iluducvuong/Do-an-khoa-so-dien-tu-Dighital-Key-/PCB/PCB.pdf

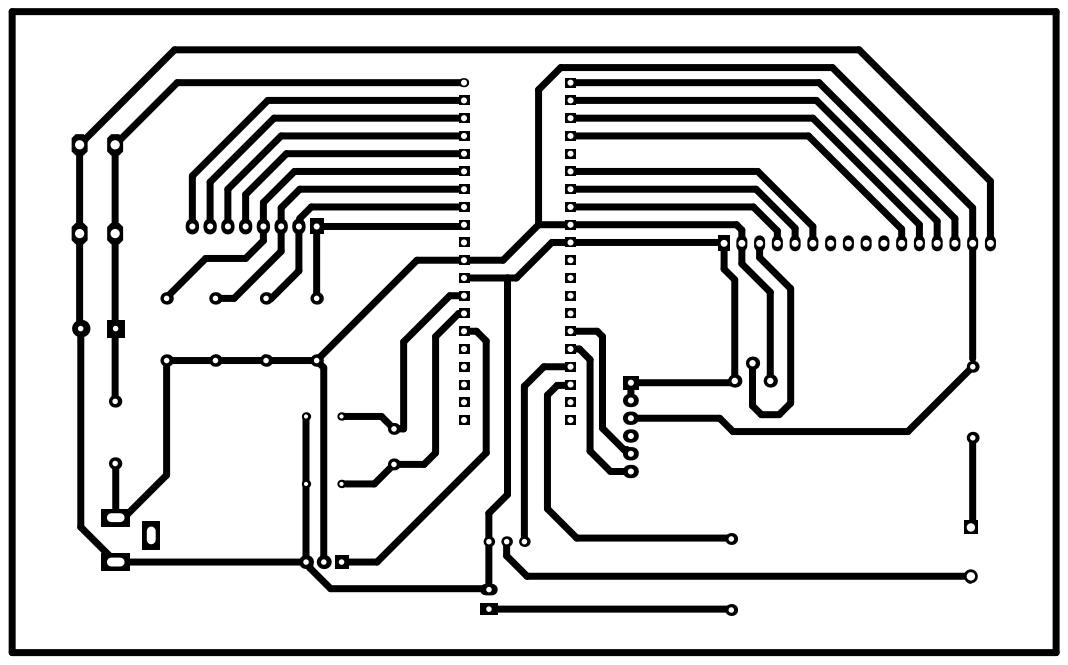
[picture p15: page 1]
