iluducvuong/Do-an-khoa-so-dien-tu-Dighital-Key-/PCB/PCB1.pdf

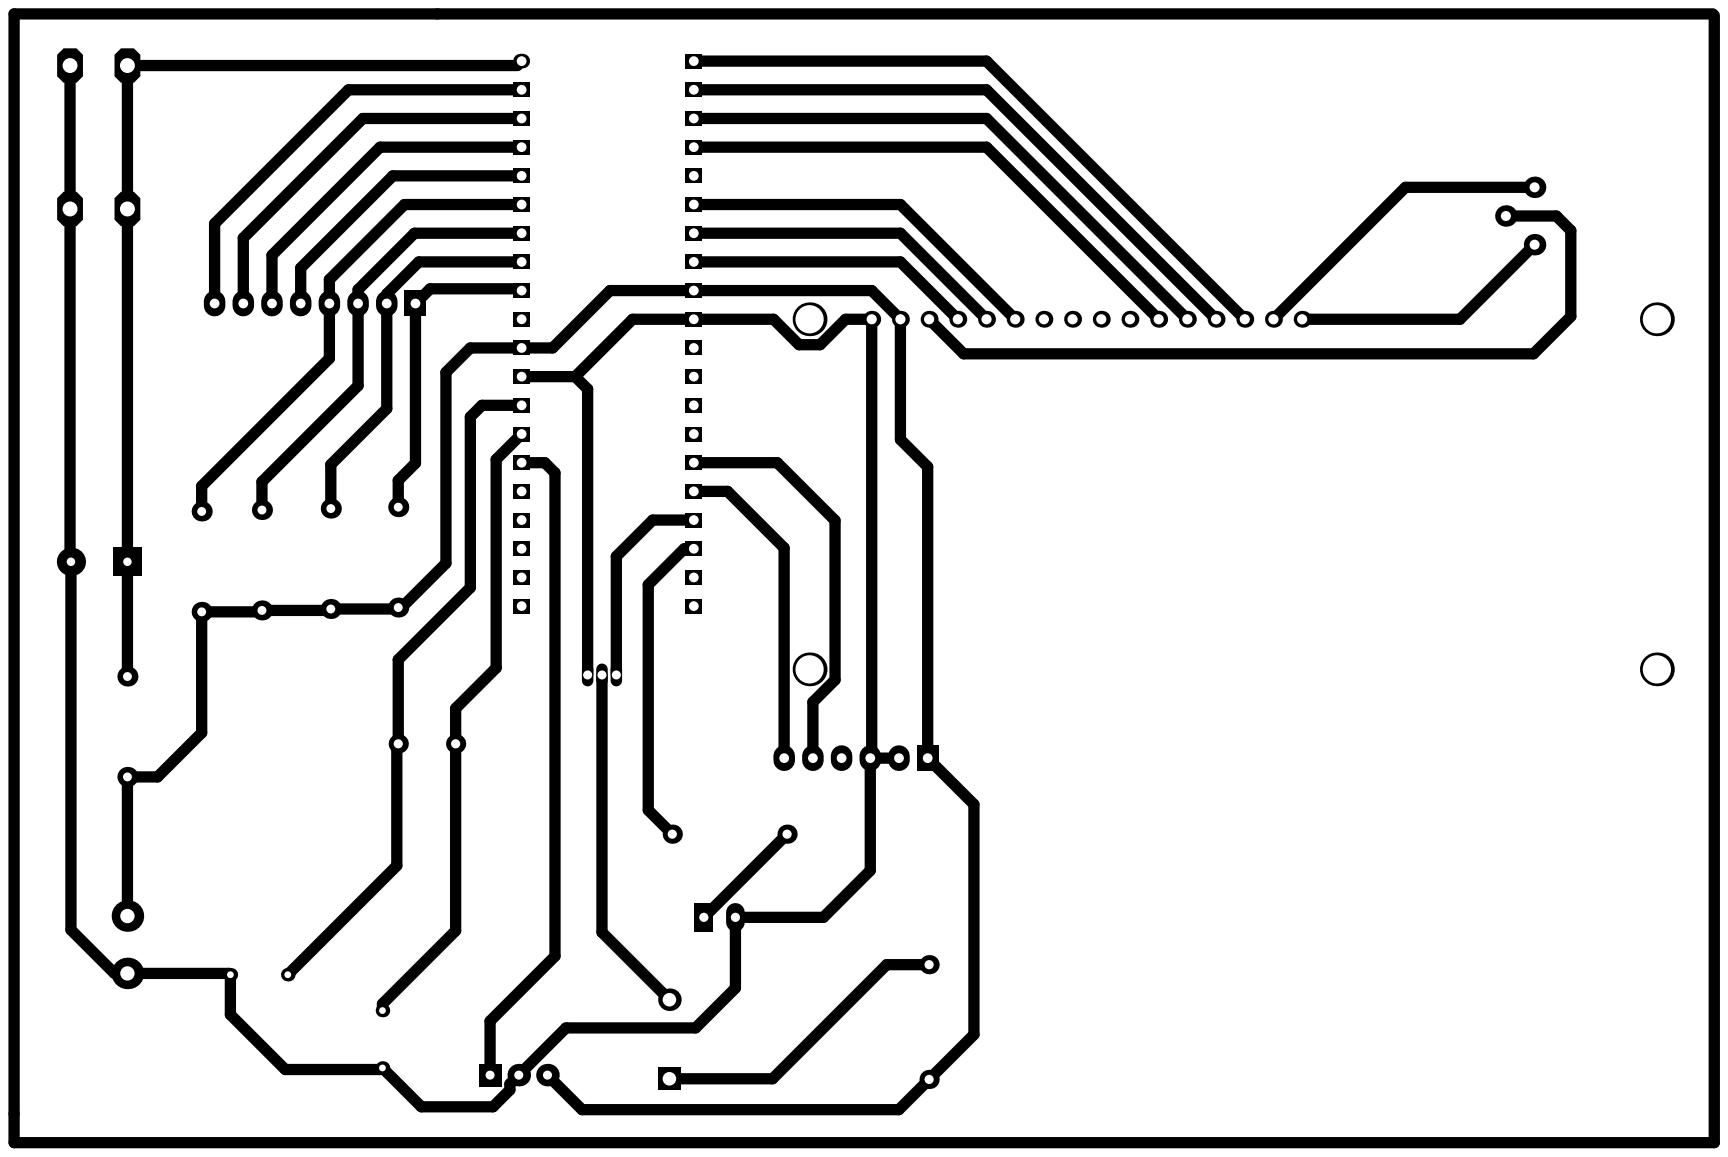
[picture p16: page 1]
