iluducvuong/Do-an-khoa-so-dien-tu-Dighital-Key-/PCB/PCB2.pdf

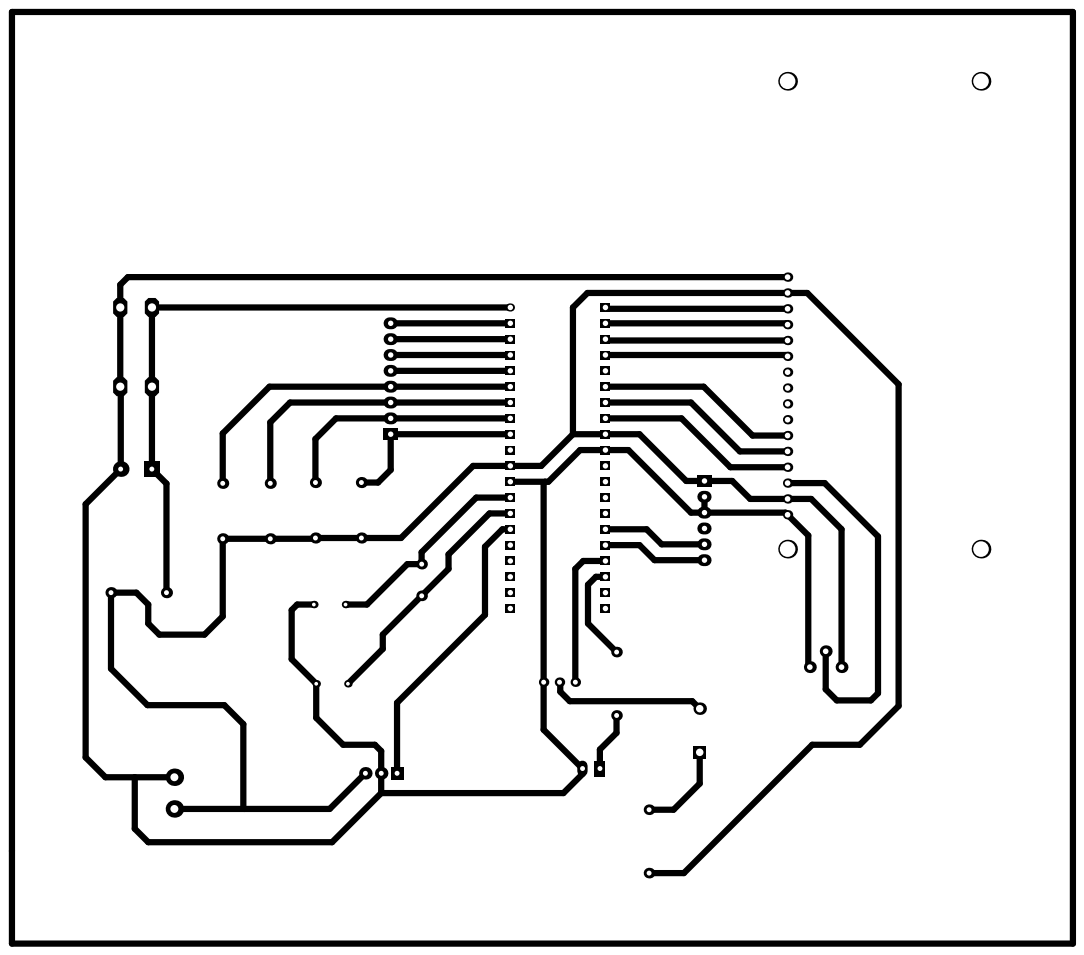
[picture p17: page 1]
