iluducvuong/Do-an-khoa-so-dien-tu-Dighital-Key-/(list of files, drawings)

Other design files:
PCB/Copy of PCB1.PcbDoc
PCB/doan.PrjPcb
PCB/PCB1.PcbDoc
PCB/PCB2.PcbDoc
PCB/Schlib1.SchLib
PCB/Schlib2.SchLib
PCB/Schlib3.SchLib
PCB/Sheet1.SchDoc
